drewtm/Fila-Mint/README

This is the Fila-Mint project.

A Google Doc of the BOM can also be viewed here:
https://docs.google.com/spreadsheet/pub?key=0Al4BWO1W5v2DdGtYRmU0VFc1MURaMEI0d0tWSEJyMkE&output=html
