drewtm/Fila-Mint/software/fila-mint desktop commander/ExtruderController/ExtruderController/Images/extruder2.bmp

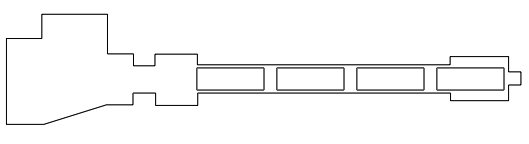
software/fila-mint desktop commander/ExtruderController/ExtruderController/Images/extruder2.bmp
