drewtm/Fila-Mint/FILA-MINT_QUICKSTART_GUIDE.pdf

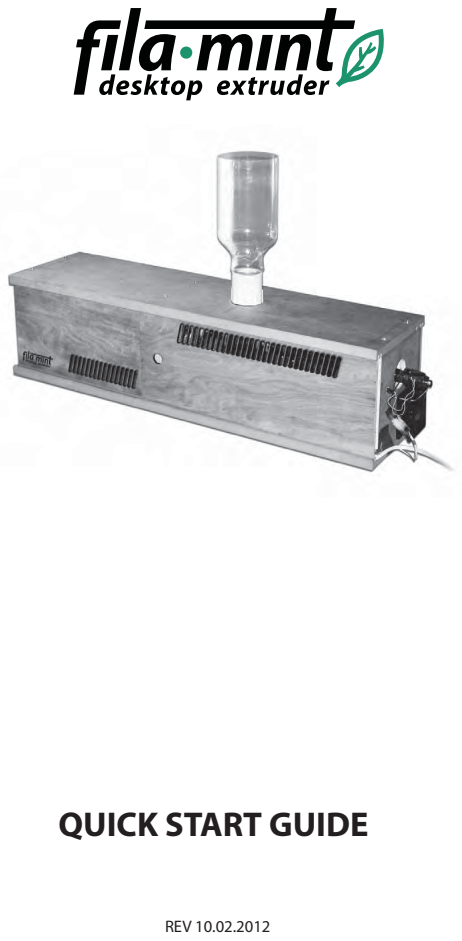
[picture p2: page 1]
REV 10.02.2012

QUICK START GUIDE

## The Fila-Mint Team Is:

April Brooks | Will Gibson | Andrew Harmon | Nate Hood | Drew Morgan | Melanie Morgan

In keeping with the spirit of The Desktop Factory Competition, we went about designing a safe, durable, inexpensive, high production desktop extruder that can be made without specialized skills or tools.

We believe that innovators worldwide who utilize 3D printing should not hesitate to create their designs because of the high cost of filament or failed prints. To this end, we hope to have built a solid framework that others will improve upon.

Our thanks to The Kauffman Foundation and Inventables for the opportunity to contribute to this important cause.

## From The Fila-Mint Team:

## SAFETY WARNINGS

The vented Fila-Mint housings are for your safety and the safety of others. Always operate the extruder with the safety housings in place.

The extruder pipe and extruder tip will get very hot during operation. Even after the heat zones have been off for several minutes, they will still be very hot.

DO NOT TOUCH

The auger is very sharp, and the motor is very strong.

KEEP YOUR FINGERS OUT OF THE FEED CHAMBER

## TABLE OF CONTENTS

## COMPONANT OVERVIEW | BASIC MECHANICAL DIAGRAM | PRE-START UP | FIRST TIME START UP | REGULAR START UP | EXTRUDING | SHUT DOWN | WIRING DIAGRAM | BILL OF MATERIALS |

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
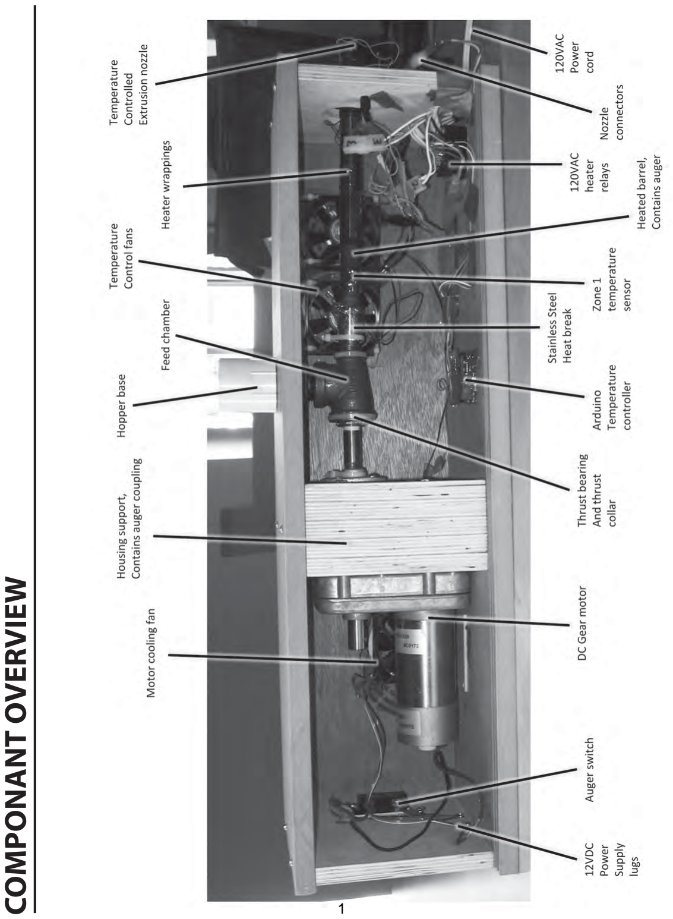
[picture p3: page 5]

## COMPONANT OVERVIEW

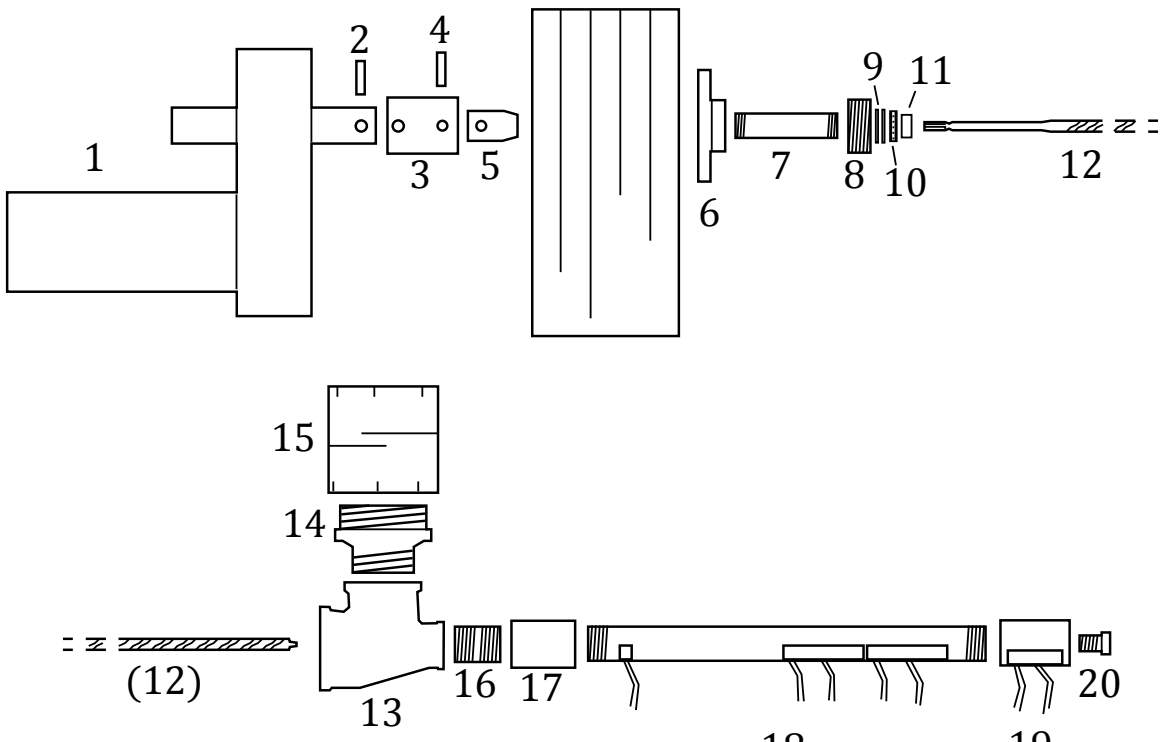
[picture p4: figure]

18 | 19
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
12 VDC Motor Roll Pin Socket Adapter Roll Pin 5/16” Socket 3/8” Steel Floor Flange 3/8” x 2 1/2” Steel Pipe Nipples 3/8” fpt x 1 1/2” mpt Adapter 1/2” Flat Washers Thrust Bearing Cage & Washer 3/8” Clamping Shaft Collar 1/2” Auger Bit Large T-Joint 1” x 1” x 1/2” (Feed Chamber) Large Plastic Pipe Adapter m/m Large Plastic Pipe Coupling f/f Feed Chamber/Heat Break Connector 1/2” fpt Stainless Coupling 1/2” x 10” Seamless sch 80 Pipe (Temp Zone 1/Heat Zones 2 & 3) 1/2” fpt x 1/8” fpt Coupling (Extrusion Tip/Heat Zone 4) 1/8” mpt End Plug (Extrusion Die)

## BASIC MECHANICAL DIAGRAM

## PRE-START UP

1. Download and install the Fila-Mint Desktop Commander application

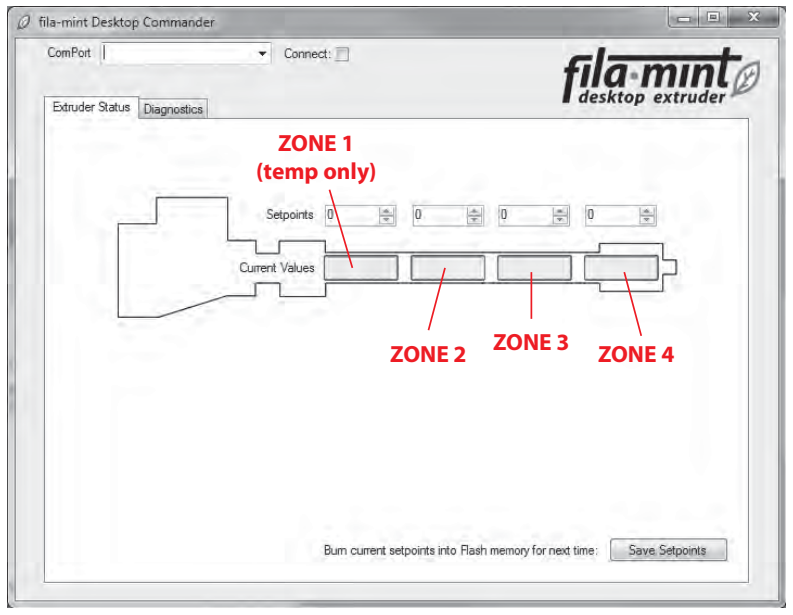
[picture p5: figure]
ZONE 1; (temp only); ZONE 2; ZONE 3; ZONE 4

2. Plug computer into Arduino USB port

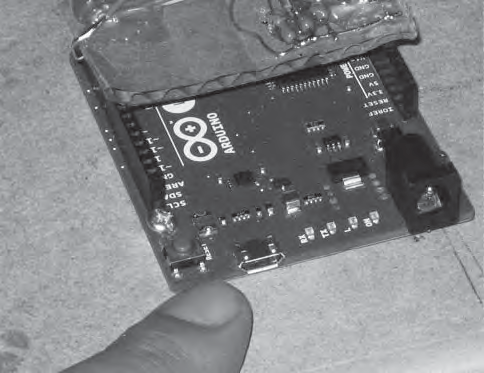
[picture p6: figure]

## PRE-START UP

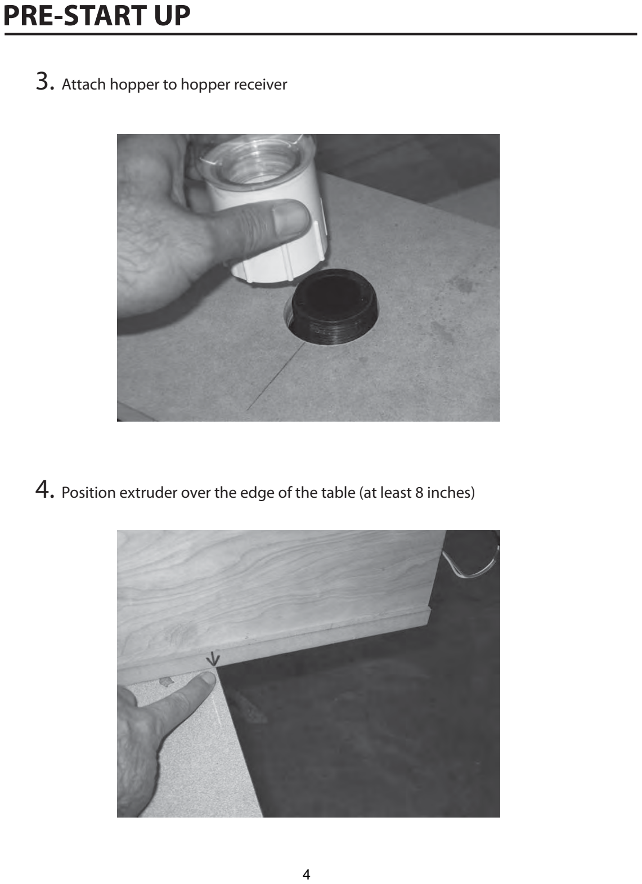
[picture p7: page 8]

3. Attach hopper to hopper receiver
4. Position extruder over the edge of the table (at least 8 inches)

## PRE-START UP

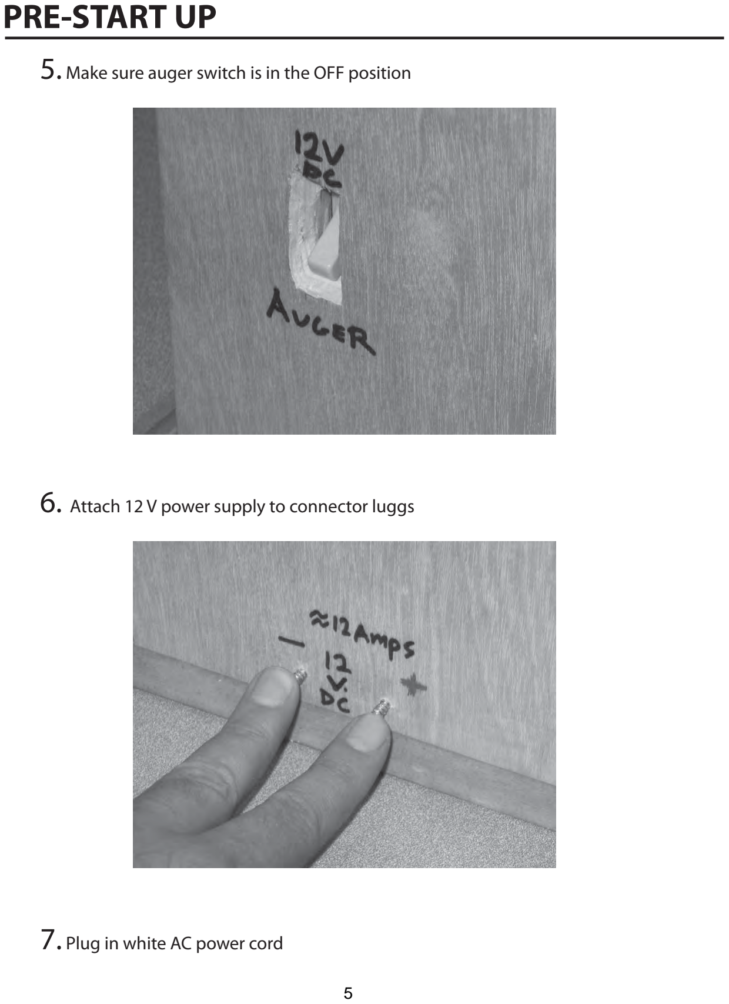
[picture p8: page 9]

5. Make sure auger switch is in the OFF position
6. Attach 12 V power supply to connector luggs
7. Plug in white AC power cord

1. Turn on heaters and enter the correct zone temperatures for the type of plastic

being extruded. Allow the temperatures to stabilize for about five minutes.

2. Turn on the auger rotation.
3. Pour pellets into the hopper.
4. See “EXTRUDING” section

## FIRST TIME START UP

1. Ensure extrusion nozzle is removed from pipe, but electrically connected. Set it

on a heat-resistant surface (a ceramic coaster on top of the Fila-Mint housing works well).

2. Turn on heaters and enter the correct zone temperatures for the type of plastic

being extruded. Allow the temperatures to stabilize for about five minutes. Ensure the nozzle is clean.

3. Turn on the auger rotation.
4. Pour pellets into the hopper.
5. Extrude a barrel-length slug of plastic from the open end of the pipe. It will look

flaky, crispy, or stringy (this is the plastic residue from the last extrusion). Extrude this slug until the plastic is smooth, free of flakes or burned plastic, and stretches easily without tearing.

6. Unplug the heater circuits from the mains.
7. Quickly turn off the auger rotation, unplug the nozzle connectors, remove any

plastic that is protruding from the pipe, screw the nozzle onto the pipe, reconnect the nozzle connectors, plug the heater circuit back into the mains, and re-start the auger rotation.

8. See “EXTRUDING” section

## NORMAL START UP

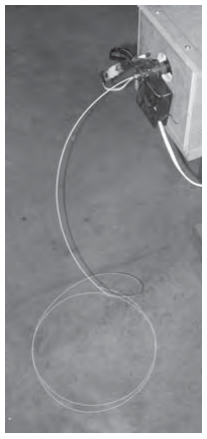
[picture p9: figure]

1. Make sure the floor area under the extruder head is smooth

and flat. The extruded filament strand will begin to gently coil on its own, and is best left undisturbed. Expect extrusion rates of 20-24 inches per minute.

2. Many variables can affect the diameter of the extrusion

including ambient air temperature, air currents in the room, the height of the extruder from the floor, humidity, etc. After several feet have been extruded, check the diameter of the strand with calipers.

## EXTRUDING

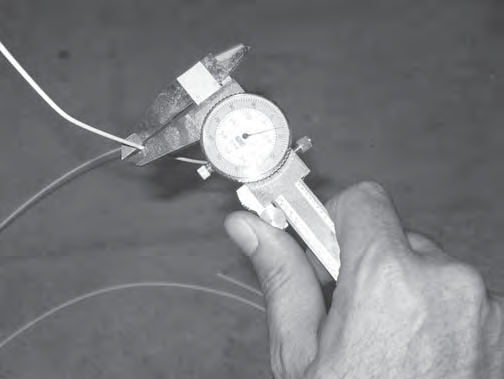
[picture p10: figure]

3. Use the front mounted nozzle fan to make fine adjustments. Pull the fan OUT for

a thicker filament. Push the fan IN for a thinner filament.

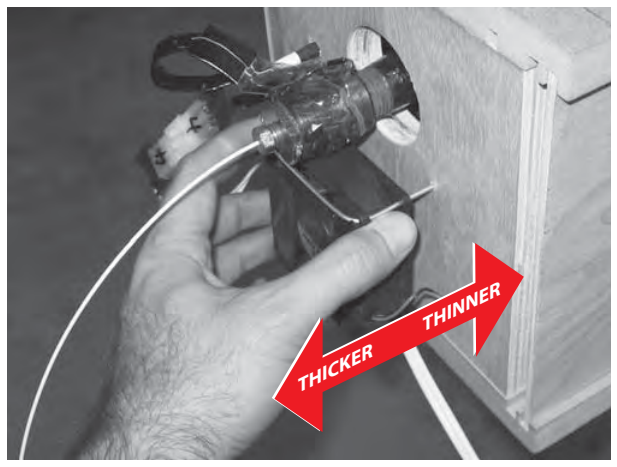
[picture p11: figure]
THICKER THINNER

1. Unplug the heater circuit from the mains.
2. Remove the nozzle and squish a forked metal object (such as a pair of slightly

open needle-nose pliers) deep into the soft plastic

3. Let the motor run until the hottest area of the pipe is below 100°C (monitor

temperatures using the Desktop Commander software).

4. When the plastic in the nozzle is nearly hard, but still quite hot, pop the whole

slug out of the nozzle in one piece. If it has cooled down too much and it's fully hardened, it usually can be unscrewed it in one piece

## SHUT DOWN

## 5V Arduino

## WIRING DIAGRAM

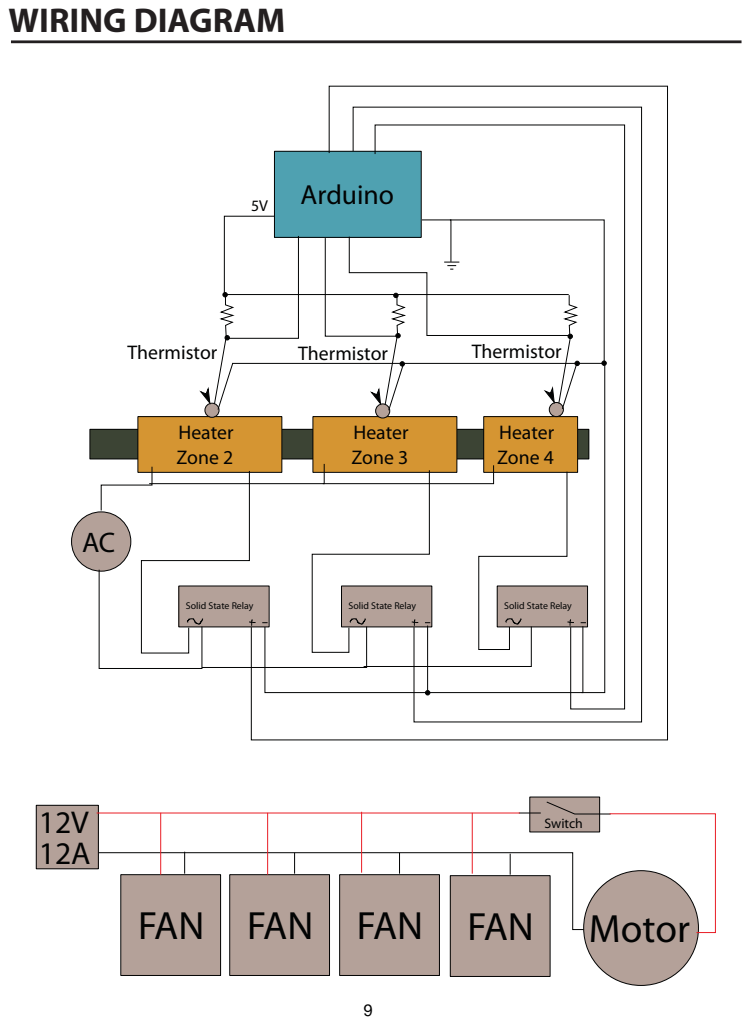
[picture p12: page 13]
Heater Zone 2; Heater Zone 3; Heater Zone 4; Solid State Relay; Thermistor; FAN; Switch; Motor

Solid State Relay

## BILL OF MATERIALS

Motor/Auger Assy.
qty | total cost
12VDC surplus | rotom | 1 | moc.retneCsulpruS99.95$ | #5-1748 | surpluscenter.com
5/16" | tekcoS | 1 | moc.lairtsudnIlabolG08.1$ | #T9FB641193 | globalindustrial.com
Socket | retpadA | 1 | 00.01$ | motsuc | machined
roll nip | 2 | 41.0$ | 9289 | 629A6 | retsamcm
1/2" flat | srehsaw | 2 | 51.0$ | 330A18019 | etsamcm | r
1/2" auger tib | 1 | niwrI79.32$ | Speedbor #3043005 | home depot
3/8" clamping sha | ralloc | 1 | 99.1$ | 31K5346 | retsamcm
thrust bearing | egac | 1 | 19.2$ | 13K9095 | retsamcm
thrust bearing | rehsaw | 2 | 69.1$ | 44K9095 | retsamcm
LATOTBUS | 19.201$

Extrusion Barrel
large T-joint | 2/1x1x1 | 1 | 50.6$ | 973K50644 | retsamcm
3/8"x2.5" steel pipe nipple | 1 | $1.47 | 44615K443 | mcmaster
3/8" steel floor | egnalf | 1 | 11.5$ | JQD8500B | 4K | nozama
3/8"fpt x 1.5"mpt adapter | 1 | $2.92 | 44605K267 | mcmaster
1/2"fpt stainless | ilpuoc | gn | 1 | 14.5$ | 453K4644 | etsamcm | r
1/2" x 10" seamless sch 80 pipe | 1 | $9.22 | 7727K205 | mcmaster
1/2"fpt x 1/8"fpt | gnilpuoc | 1 | 47.7$ | 434K4644 | retsamcm
1/8"mpt end | gulp | 1 | 69.0$ | 8705 | 433K5 | retsamcm
large plasc pipe adapter m/m | 1 | $2.88 | 46885K307 | mcmaster
large plasc pipe coupling f/f | 1 | $0.86 | 4880K85 | mcmaster
TOTBUS | LA | 26.24$

Housing
5x 7" square 12mm | doowylp | 51.1$ | 370661 | emoh | depot in OK
4x 1/4-20 x 3.5 hex | stlob | 47.0$ | 655A63219 | retsamcm
4x 1/4" fender | srehsaw | 20.0$ | 9019 | 801A0 | retsamcm
4x 1/4" plain | srehsaw | 90.0$ | 920A62109 | retsamcm
4x 1/4" spring | srehsaw | 70.0$ | 920A20119 | mcmaster
4x 2.25" by .25" diam | slewod | 60.0$ | nozama | ozama | n
wood lg eu | 01.0$ | tamitse | de | suoirav
4x 10-24 tee | stun | 53.0$ | 240A57909 | retsamcm | carr
4x 10-24 flat head | swercs | 12.0$ | 542A37209 | etsamcm | r carr
various | sdraob | 00.5$ | ?
various wood | swercs | 00.2$ | ?
LATOTBUS | 97.9$

Electronics/Heaters
Arduino | odranoel | 1 | 69.91$ | VED -11286 | sparkfun
nichrome wire 32awg | '05 | 1 | 36.0$ | 23K0888 | etsamcm | r
kapton | epat | 1 | 59.0$ | repuS | wide | makerbot
4x solid state | syaler | 4 | 48.51$ | MOC | -10636 | sparkfun
srotsiser | 4 | 60.1$ | RB1051C55NR | resuom
srotsimreht | 4 | 88.5$ | F401G06575B | resuom
2 high-temp | eriw | 1 | 65.3$ | 602-3112010-100 | mouser
2.5 low-temp | eriw | 1 | 01.0$ | 206 -882205-100-09 | mouser
wall outlet | gulp | 1 | 66.1$ | 65 2-221001-08 | mouser
power | 1 c | srotcenno | 3 | 7578.0$ | -7703401, 571-7703421 | mouser
power connector p sni | 6 | 17507.0$ | -7940181, 571-7940191 | mouser
thermistor | 7 c | srotcenno | 4 | 3710.2$ | -ADC-002-1, 173-5521-ST-EX | mouser
snaF | 3 | 07.11$ | 076 -OD8025-12HSS | mouser
LATOTBUS | 29.46$
LATOT | 42.022$
